Saininavjot/Capstone-Project-Group-1/BLOCK_DIAGRAM.png

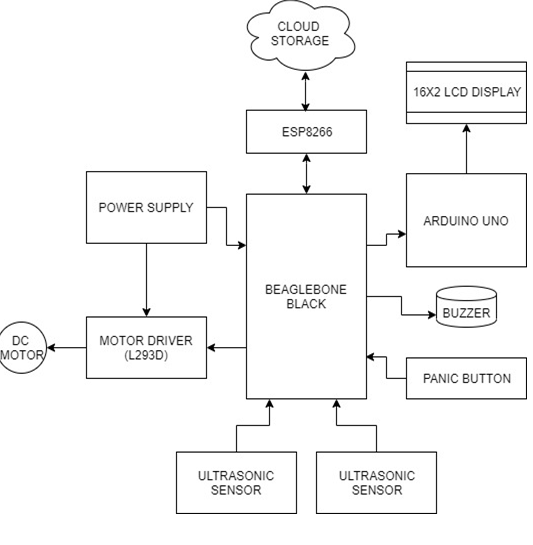
BLOCK_DIAGRAM.png
