Saininavjot/Capstone-Project-Group-1/(threads)

Thread 1 (2020-10-19):

Schematic Capture

mikeshams, 2020-10-19:
Navjot - What issues did you face working with fritzing? How did you resolve them?

Saininavjot, 2020-10-22:
There are various issues that I faced while working with fritzing software. I was learning this software and preparing schematic design for my project on this software:
 Issues that I faced while working with fritzing software are as follows:
1. Downloading and Installing Fritzing:
The latest version of fritzing is version 0.9.4, but this version is paid. However, I was looking for version that is free of cost. So, I downloaded fritzing version 0.9.3. But, it comes with its own cons. The version 0.9.3 does not have latest Microcontrollers like Beaglebone Black and latest interfacing modules.
To resolve this issue: There is option in fritzing to import parts from online library of fritzing. This worked for me to work with fritzing version 0.9.3.
2. To find all part libraries:
The first step to prepare schematic design on fritzing version 0.9.3 is to check whether fritzing have all required part libraries or not. In parts window, I searched for all parts required to prepare schematic design. I was able to find almost all modules like ultrasonic sensor, Arduino Uno, LCD Display etc. However, two modules that I would not able to find was Beaglebone Black and ESP 8266. As, fritzing version 0.9.3 do not have all modules preinstalled in it. Firstly, I tried to customize these two modules on Fritzing using any general IC, but it was time consuming as I have to describe each pin of that IC with Beaglebone black pins.
To resolve this issue: I tried to look for Fritzing parts library on internet specifically for Beaglebone black and ESP 8266. All the fritzing parts libraries have expension .fzpz. So, I looked specifically for beaglebone black with .fzpz extension file. I got this library on github: https://github.com/adafruit/Fritzing-Library/blob/master/parts/BeagleBone%20Black.fzpz
Similarly, I got .fzpz file for ESP 8266 from link given below:
https://github.com/ydonnelly/ESP8266_fritzing/blob/master/ESP8266-12E%20WiFi%20Module.fzpz
3. Setting up grid size for all parts:
Some of the parts appear quite big and are not aligned to grid. The grid size of new parts is different from old parts.
To resolve this issue: In part editor of each part, in view option. We can change grid size for each component to 0.1 inch and there is also option to align part to the grid. So, all the parts in the schematic diagram are aligned to –grid and set to grid size of 0.2 inch.

Closed 2020-10-23.

Thread 2 (2020-10-26):

Testing of components

mikeshams, 2020-10-26:
Ramneet - 1) What issues did you face with during testing the components? 2) How did you fix them?

embedded92, 2020-10-30:
Following are the problems I faced while testing the Hardware Components of the project:

1. Another issue I faced was a huge amount of inconsistency with the connections of the male jumper wires into the breadboard. For a long time, I thought I had bad components but later realized that it was the loose connections. Then few jumper wires were discarded and more attention was paid to these contacts.

2. To test LCD, I needed to use a potentiometer to adjust the contrast of the LCD screen. To adjust the potentiometer, it has a cross-head screw but I didn't have a cross-head screwdriver. The default setting of the potentiometer was set to min, which leads to no contrast on the LCD screen. First, I decided to use some resistance directly on the contrast pin, but it was taking more time to tune the contrast. Then while searching for some other components, I found an older potentiometer mixed with some resistors which have a slotted knob. Then I used that potentiometer to test the Lcd.

3. Another problem that we faced was during the testing of the buzzer. While testing the buzzer, I observed that it is not beeping correctly, First I tried to check the connections to the buzzer, but they were correct and properly connected to the buzzer which led me to realize that the buzzer was faulty. I changed the buzzer to the spare buzzer and then it was working as expected.

Closed 2020-10-30.

Thread 4 (2020-11-02):

Button & Buzzer Interfacing

mikeshams, 2020-11-02:
Navjot - 1) What issues did you face when interfacing the button and buzzer? 2) How did you resolve them? 3) On the terminal you were getting "Operation not permitted" error. How should you manage it?

embedded92, 2020-11-05:
Issues that we faced while Interfacing Buzzer and Push Button with Beaglebone Black:
1. Accessing GPIO pins of Beaglebone Black: The major issue is that we can not program the GPIO pins of Beaglebone Black directly. Multiple layers are present between user and Beaglebone Black. First of all, major challenge is to research about ways by which we can access the GPIO pins of Beaglebone Black.
Resolving this issue: We have done a thorough research and come across various ways of accessing and programming GPIO pins of Beaglebone black. Some of the methods are:
a) Using Command line terminal commands:
Before writing and reading data from the GPIO pins, we need to export the pins and give direction to the pin (input or output). We interact with BBB pins via a set of files that are read/written to. To reach the directory where these files are located, enter the following.
cd /sys/class/gpio
To access any GPIO pin, first need to export that file using command:
echo  22 > export, Where 22 represent gpio pin 22.
Echo 1 > value, to set value of pin 1 or 0
Echo out > direction, to send the direction of the pin
b)  Accessing pins through C library:
This method we have included in our project to access GPIO pins through C files:
Gpio.c and  Gpio.h, These files are included in our C project to access the pins.
The links for these files are:
https://gist.github.com/ajmontag/4013192
https://developer.ridgerun.com/wiki/index.php?title=Gpio-int-test.c
2. File path declaration in Program:
Earlier, in the program, we have not given full path of file to access pins. Because of this, program was showing error. Moreover, we get to know later on that we have to close file that means free up the pins before using these pins.
Resolving this Issue: The full path of file export path is given at which gpio pins are present on the gpio_control.c files. Everytime, if we want to read or write values to the pin, we have to give paths for files.
  fd = open("/sys/class/gpio/export", O_WRONLY);//file descriptor
We created a separated function called clean_up_system( ) in which we free up the pins to be used in main( ) function. So, before performing read and write operation in the main code, we called clean_up_system( ) function in main program.
/*
 * Freeup all the pins used in the project
 */
static void clean_up_system(void)
{
    // unexport and free up gpios
    gpio_control_free_pin(BUZZER_GPIO_PIN);
    gpio_control_free_pin(SWITCH_GPIO_PIN);
}
2. Terminal "Operation not permitted" error. How should you manage it?
While trying to access the GPIO pins through line, I faced issue while exporting pins. There is error “Operation not permitted” when I was running command : echo 22 > export.
To resolve this issue:
I research about this error on Google and come across various options to resolve this issue:
1. While accessing pins, I access the pins by becoming root user using command: sudo su
As a root, it is possible to access the pins.
Secondly, I unexport the pin first before exporting it. As, sometimes resources are busy, so to use any pin. First, we need to set the pin free by unexporting it.
echo 20 > unexport
root@beaglebone:/sys/class/gpio# ls
export  gpio111  gpio115  gpio13  gpio2   gpio26  gpio31  gpio35  gpio39  gpio46  gpio5   gpio61  gpio66  gpio7   gpio73  gpio77  gpio80  gpio88     gpiochip32
gpio10  gpio112  gpio116  gpio14  gpio20  gpio27  gpio32  gpio36  gpio4   gpio47  gpio50  gpio62  gpio67  gpio70  gpio74  gpio78  gpio81  gpio89     gpiochip64
gpio11  gpio113  gpio117  gpio15  gpio22  gpio3   gpio33  gpio37  gpio44  gpio48  gpio51  gpio63  gpio68  gpio71  gpio75  gpio79  gpio86  gpio9      gpiochip96
gpio110  gpio114  gpio12   gpio19  gpio23  gpio30  gpio34  gpio38  gpio45  gpio49  gpio60  gpio65  gpio69  gpio72  gpio76  gpio8   gpio87  gpiochip0  unexport
root@beaglebone:/sys/class/gpio# echo 20 > export
bash: echo: write error: Operation not permitted
root@beaglebone:/sys/class/gpio# echo 20 > unexport
bash: echo: write error: Invalid argument
root@beaglebone:/sys/class/gpio# echo 20 > unexport
bash: echo: write error: Invalid argument
root@beaglebone:/sys/class/gpio# echo 20 > export
root@beaglebone:/sys/class/gpio# cd gpio20
root@beaglebone:/sys/class/gpio/gpio20# echo out > direction
root@beaglebone:/sys/class/gpio/gpio20# cat direction
out
root@beaglebone:/sys/class/gpio/gpio20# echo 1 > value
root@beaglebone:/sys/class/gpio/gpio20# cat value
1
root@beaglebone:/sys/class/gpio/gpio20#

embedded92, 2020-11-05:
Issues that we faced while Interfacing Buzzer and Push Button with Beaglebone Black:
1. Accessing GPIO pins of Beaglebone Black: The major issue is that we can not program the GPIO pins of Beaglebone Black directly. Multiple layers are present between user and Beaglebone Black. First of all, major challenge is to research about ways by which we can access the GPIO pins of Beaglebone Black.
Resolving this issue: We have done a thorough research and come across various ways of accessing and programming GPIO pins of Beaglebone black. Some of the methods are:
a) Using Command line terminal commands:
Before writing and reading data from the GPIO pins, we need to export the pins and give direction to the pin (input or output). We interact with BBB pins via a set of files that are read/written to. To reach the directory where these files are located, enter the following.
cd /sys/class/gpio
To access any GPIO pin, first need to export that file using command:
echo  22 > export, Where 22 represent gpio pin 22.
Echo 1 > value, to set value of pin 1 or 0
Echo out > direction, to send the direction of the pin
b)  Accessing pins through C library:
This method we have included in our project to access GPIO pins through C files:
Gpio.c and  Gpio.h, These files are included in our C project to access the pins.
The links for these files are:
https://gist.github.com/ajmontag/4013192
https://developer.ridgerun.com/wiki/index.php?title=Gpio-int-test.c
2. File path declaration in Program:
Earlier, in the program, we have not given full path of file to access pins. Because of this, program was showing error. Moreover, we get to know later on that we have to close file that means free up the pins before using these pins.
Resolving this Issue: The full path of file export path is given at which gpio pins are present on the gpio_control.c files. Everytime, if we want to read or write values to the pin, we have to give paths for files.
  fd = open("/sys/class/gpio/export", O_WRONLY);//file descriptor
We created a separated function called clean_up_system( ) in which we free up the pins to be used in main( ) function. So, before performing read and write operation in the main code, we called clean_up_system( ) function in main program.
/*
 * Freeup all the pins used in the project
 */
static void clean_up_system(void)
{
    // unexport and free up gpios
    gpio_control_free_pin(BUZZER_GPIO_PIN);
    gpio_control_free_pin(SWITCH_GPIO_PIN);
}
2. Terminal "Operation not permitted" error. How should you manage it?
While trying to access the GPIO pins through line, I faced issue while exporting pins. There is error “Operation not permitted” when I was running command : echo 22 > export.
To resolve this issue:
I research about this error on Google and come across various options to resolve this issue:
1. While accessing pins, I access the pins by becoming root user using command: sudo su
As a root, it is possible to access the pins.
Secondly, I unexport the pin first before exporting it. As, sometimes resources are busy, so to use any pin. First, we need to set the pin free by unexporting it.
echo 20 > unexport
root@beaglebone:/sys/class/gpio# ls
export  gpio111  gpio115  gpio13  gpio2   gpio26  gpio31  gpio35  gpio39  gpio46  gpio5   gpio61  gpio66  gpio7   gpio73  gpio77  gpio80  gpio88     gpiochip32
gpio10  gpio112  gpio116  gpio14  gpio20  gpio27  gpio32  gpio36  gpio4   gpio47  gpio50  gpio62  gpio67  gpio70  gpio74  gpio78  gpio81  gpio89     gpiochip64
gpio11  gpio113  gpio117  gpio15  gpio22  gpio3   gpio33  gpio37  gpio44  gpio48  gpio51  gpio63  gpio68  gpio71  gpio75  gpio79  gpio86  gpio9      gpiochip96
gpio110  gpio114  gpio12   gpio19  gpio23  gpio30  gpio34  gpio38  gpio45  gpio49  gpio60  gpio65  gpio69  gpio72  gpio76  gpio8   gpio87  gpiochip0  unexport
root@beaglebone:/sys/class/gpio# echo 20 > export
bash: echo: write error: Operation not permitted
root@beaglebone:/sys/class/gpio# echo 20 > unexport
bash: echo: write error: Invalid argument
root@beaglebone:/sys/class/gpio# echo 20 > unexport
bash: echo: write error: Invalid argument
root@beaglebone:/sys/class/gpio# echo 20 > export
root@beaglebone:/sys/class/gpio# cd gpio20
root@beaglebone:/sys/class/gpio/gpio20# echo out > direction
root@beaglebone:/sys/class/gpio/gpio20# cat direction
out
root@beaglebone:/sys/class/gpio/gpio20# echo 1 > value
root@beaglebone:/sys/class/gpio/gpio20# cat value
1
root@beaglebone:/sys/class/gpio/gpio20#

Saininavjot, 2020-11-05:
Issues that we faced while Interfacing Buzzer and Push Button with Beaglebone Black:
1. Accessing GPIO pins of Beaglebone Black: The major issue is that we can not program the GPIO pins of Beaglebone Black directly. Multiple layers are present between user and Beaglebone Black. First of all, major challenge is to research about ways by which we can access the GPIO pins of Beaglebone Black.
Resolving this issue: We have done a thorough research and come across various ways of accessing and programming GPIO pins of Beaglebone black. Some of the methods are:
a) Using Command line terminal commands:
Before writing and reading data from the GPIO pins, we need to export the pins and give direction to the pin (input or output). We interact with BBB pins via a set of files that are read/written to. To reach the directory where these files are located, enter the following.
cd /sys/class/gpio
To access any GPIO pin, first need to export that file using command:
echo  22 > export, Where 22 represent gpio pin 22.
Echo 1 > value, to set value of pin 1 or 0
Echo out > direction, to send the direction of the pin
b)  Accessing pins through C library:
This method we have included in our project to access GPIO pins through C files:
Gpio.c and  Gpio.h, These files are included in our C project to access the pins.
The links for these files are:
https://gist.github.com/ajmontag/4013192
https://developer.ridgerun.com/wiki/index.php?title=Gpio-int-test.c
2. File path declaration in Program:
Earlier, in the program, we have not given full path of file to access pins. Because of this, program was showing error. Moreover, we get to know later on that we have to close file that means free up the pins before using these pins.
Resolving this Issue: The full path of file export path is given at which gpio pins are present on the gpio_control.c files. Everytime, if we want to read or write values to the pin, we have to give paths for files.
  fd = open("/sys/class/gpio/export", O_WRONLY);//file descriptor
We created a separated function called clean_up_system( ) in which we free up the pins to be used in main( ) function. So, before performing read and write operation in the main code, we called clean_up_system( ) function in main program.
/*
 * Freeup all the pins used in the project
 */
static void clean_up_system(void)
{
    // unexport and free up gpios
    gpio_control_free_pin(BUZZER_GPIO_PIN);
    gpio_control_free_pin(SWITCH_GPIO_PIN);
}
2. Terminal "Operation not permitted" error. How should you manage it?
While trying to access the GPIO pins through line, I faced issue while exporting pins. There is error “Operation not permitted” when I was running command : echo 22 > export.
To resolve this issue:
I research about this error on Google and come across various options to resolve this issue:
1. While accessing pins, I access the pins by becoming root user using command: sudo su
As a root, it is possible to access the pins.
Secondly, I unexport the pin first before exporting it. As, sometimes resources are busy, so to use any pin. First, we need to set the pin free by unexporting it.
echo 20 > unexport
root@beaglebone:/sys/class/gpio# ls
export  gpio111  gpio115  gpio13  gpio2   gpio26  gpio31  gpio35  gpio39  gpio46  gpio5   gpio61  gpio66  gpio7   gpio73  gpio77  gpio80  gpio88     gpiochip32
gpio10  gpio112  gpio116  gpio14  gpio20  gpio27  gpio32  gpio36  gpio4   gpio47  gpio50  gpio62  gpio67  gpio70  gpio74  gpio78  gpio81  gpio89     gpiochip64
gpio11  gpio113  gpio117  gpio15  gpio22  gpio3   gpio33  gpio37  gpio44  gpio48  gpio51  gpio63  gpio68  gpio71  gpio75  gpio79  gpio86  gpio9      gpiochip96
gpio110  gpio114  gpio12   gpio19  gpio23  gpio30  gpio34  gpio38  gpio45  gpio49  gpio60  gpio65  gpio69  gpio72  gpio76  gpio8   gpio87  gpiochip0  unexport
root@beaglebone:/sys/class/gpio# echo 20 > export
bash: echo: write error: Operation not permitted
root@beaglebone:/sys/class/gpio# echo 20 > unexport
bash: echo: write error: Invalid argument
root@beaglebone:/sys/class/gpio# echo 20 > unexport
bash: echo: write error: Invalid argument
root@beaglebone:/sys/class/gpio# echo 20 > export
root@beaglebone:/sys/class/gpio# cd gpio20
root@beaglebone:/sys/class/gpio/gpio20# echo out > direction
root@beaglebone:/sys/class/gpio/gpio20# cat direction
out
root@beaglebone:/sys/class/gpio/gpio20# echo 1 > value
root@beaglebone:/sys/class/gpio/gpio20# cat value
1
root@beaglebone:/sys/class/gpio/gpio20#

Closed 2020-11-13.

Thread 8 (2020-11-10):

Interfacing the ultra sonic

mikeshams, 2020-11-10:
Ramneet - 1) What issues did you face when interfacing the ultra sonic? 2) How did you resolve them?

embedded92, 2020-11-13:
Issues that I faced while interfacing Ultrasonic sensors with Beaglebone black are as follows:

1. Issue: Ultrasonic sensor requires a 5v operating power supply. Firstly, I tried to power ultrasonic sensors from beaglebone onboard VDD power supply of 5v. But, when 0I tried running code on the terminal, there was no output from the ultrasonic sensor. I checked all the connections and code again, but still, the sensors were not operating.

Resolving this issue: I tried to find the underlying cause of this issue. One of the points that I get to know is that the Beaglebone black on board VDD pin only works if beaglebone is connected to power adaptor and getting constant 5 VDC, 2.5 A, barrel-plug supply. Another point I get to know is SYS 5v can be used if current drawn from the board by a sensor is under 500 m A. The SYS 5V pin can be used if Beaglebone black is powered by a USB cable. As, the ultrasonic sensor only draws 15 mA of current, so it is safe to use the SYS 5V pin to power beaglebone black.

https://cdn-shop.adafruit.com/datasheets/BBB_SRM.pdf

2. Issue: Earlier, in the code, I did not mention about range in centimeter within which ultrasonic sensor should detect obstacles. As in our project, the ultrasonic sensors' role is to detect the arrival and departure of the train, and sensors were placed just 3m to 4 cm away from the railway track. Earlier, this range was not specified. So, sensors were detecting any objects even from a far distance like walls, tables, etc.

Resolving this Issue: In the code, I mentioned about specific range within which sensors should detect train. If the distance is between 4 and 6 cm, then only the sensor will detect that object like a train.

if ( distance>= 4 && distance =< 6)
            {
                        printf("train arriving......\r\n");
                        printf("Distance= %d \r\n", distance);
                        printf("\r\n", distance);
            }

3. Issue: Earlier, I did not get the perfect library to access the GPIO pins of Beaglebone Black. There are few general libraries that can be used for any processor for accessing GPIO pins. But, I was not able to find specifically for beaglebone black.

Resolving this Issie:
I come across the specific library for beaglebone black, i.e., IOBB library at GitHub:

https://github.com/shabaz123/iobb

There were few steps to be followed while installing and downloading IOBB library.
1.         mkdir development
2.         cd development
3.         git clone https://github.com/shabaz123/iobb.git
4.         cd iobb
5.         make
6.         make install

Closed 2020-11-13.

Thread 9 (2020-11-16):

Interfacing stepper motor with BeagleBone Black

mikeshams, 2020-11-16:
Navjot - What issues did you face when Interfacing stepper motor with BeagleBone Black? How did you resolve them?

Saininavjot, 2020-11-20:
Issues that I faced while interfacing stepper motor with BBB are as follows:
1. Writing C code for stepper motor:
Programming stepper motor was bit challenging for us as we have to rotate motor in clockwise of anticlockwise direction using GPIO pins of Beaglebone Black. Programming stepper motor is not as easy as DC motor. Here, we have to configure step size and number of steps to be taken by motor to rotate at particular angle. First challenge was to research about how to calculate number of steps for 90 degree rotation of stepper motor. We write the C code for stepper motor, but while running the code on linux terminal, motor was not responding. There was some issue in the code.
Resolving this issue: All the connections were fine but code was working as per requirement to rotate the motor. Then, we researched about functioning of stepper motor and we get to know some basic details about motor such as how to calculate number of steps from step angle. Secondly, it is important to decide whether to use 4 step sequence or 8 step sequence to rotation of motor.
We decided to go with 4 step sequence,  that means combination of wires are as follows:
AB-BC-CD-DA
We followed to following links to program our stepper motor.
1. This link provide us with basic understanding to program stepper motor in 4 step sequence
https://www.instructables.com/BYJ48-Stepper-Motor/
2. This link helps us to write C code for stepper motor interfacing with Beaglebone Black.
https://bwgz57.wordpress.com/2012/04/03/beaglebone-stepping-out/
To calculate number of steps for 90 degree rotation in 4 step sequences, the formula used is as follows:
 Steps = Number of steps in One Revolution * Gear ratio = 32*64 = 2048
To rotate by 90 degree: 2048/4 = 512
2. Appropriate power supply:
The second issue is to power ULN2003 driver from appropriate power source. ULN2003 driver further power stepper motor with required voltage and current. Earlier, we powered ULN2003 driver from Beaglebone Black 5v on board pin. But, powering high current motor from Beaglebone Black can result in destruction of Microcontroller. So, we need some alternative so as to make sure that Beaglebone is operated in safe condition without its failure.
To resolve this issue: We decided to use external power module for power our ULN2003 driver. So, we used adjustable power module that can provide power from range 3.3V to 12 V to any device that is operated in this range. This power module is further connected to power adaptor. The power module provide 5V power supply to driver circuit as well as appropriate current of 500 mA.

Closed 2020-11-20.

Thread 12 (2020-11-24):

interfacing the WiFi Module

mikeshams, 2020-11-24:
Ramneet - 1) What issues did you encounter when interfacing the WiFi Module? 2) How did you resolve them?

embedded92, 2020-11-27:
While interfacing beaglebone with esp8266 I faced the problem that the Arduino platform for ESP only supports two UART and 2nd UART of ESP only supports TX. For our testing, I needed two UARTs as one is connected to beaglebone and 2nd is used for seeing the logs.
I tried using UART 2 for seeing the logs, but it was not working properly. To resolve this I switched to using software UART which enables using any GPIO pins of ESP to be used as UART. I finally used D5 and D6 GPIO pin of ESP as RX and TX respectively and for this "SoftwareSerial.h" header file was used.

Closed 2020-11-27.

Thread 15 (2020-12-01):

interfacing the project to the cloud

mikeshams, 2020-12-01:
Ramneet - What issues did you face interfacing the project to the cloud? How did you resolve them? Modify the charts as instructed.

embedded92, 2020-12-04:
-Issues faced while interfacing the project to the cloud:
Sometimes due to the low signal strength of wifi(usually between -70to -80dBm) in my room, ESP8266 was not able to connect to Wi-Fi and hence was not able to connect to MQTT broker(cloud).
To resolve this issue I had to move out of my room and then try the connection, also I requested my pg owner to install a signal repeater.

-Modify the charts as instructed:
We are using the trial version of thingspeak that has only limited options to add visuals and graphs to represent data. We have tried to make a few changes to make data representation more clear and readable. In order to do so, we have done two 2 things, first, added titles to the X and Y axis, and second, added a button-like visual to Field 4 which represents the "Emergency" situation.

-Bug:
While demonstrating the project in the class after my presentation, I was not able to show updated data on the cloud. The reason being, while making the hardware connections more clear I somehow connected the RX and TX of BBB-ESP8266 wrong(used 9-11 instead of 11-13 pins of BBB). Due to which BBB was not able to send any data to ESP and ESP was unable to update the cloud.
I, later on, made the connections right and gave a demo in the class.

Closed 2020-12-04.

Thread 16 (2020-12-08):

Interfacing the LCD Display to the BBB

mikeshams, 2020-12-08:
Navjot - 1) What issues did you face when Interfacing the LCD Display to the BBB? 2) How did you resolve them? 3) Why did not you use I2C protocol for communication? 4) Why are not you able to change the font size?

Saininavjot, 2020-12-11:
Issues that I faced while interfacing LCD Display with BBB:
1. Interfacing Arduino Uno with BBB:
The GPIO pins of Beaglebone black are 3.3V and can be configured as inputs or outputs. The max output current varies by pin. For some pins it is 4mA and for some pins it is 6mA. The inputs are not 5V tolerant. The max voltage is 3.3V for GPIO pins. On the other hand, Input and output pins of Arduino Uno require operating voltage of 5V. If 5v signal is send back from Arduino Uno to BBB, it can destroy the Beaglebone board.
Resolving issue: Earlier, we thought of using Logic level convertor between Arduino and BBB. As logic level convertor converts 5v signal to 3.3v which is further given as input to the BBB. But, in our project, we do not require any acknowledgement of letters (data) received by Arduino back to BBB. We are not sending any data back to Beaglebone black. There is only transmission of data from BBB to receiver pin of Arduino. So, board is operated in safe conditions and our purpose is served as well.
2. Running code on Arduino IDE: When I tried to upload code into Arduino Board using Arduino IDE. It was showing error in code uploading and failed to upload the code. An error was displayed on the IDE.
Resolving Issue: As Arduino Board was connected with Laptop using USB cable. The Arduino IDE was sending code to Arduino Board using USB protocol. Also, the receiver pin of the Arduino board was connected to transmission pin of BBB. As Arduino Board was receiving data from BBB using UART protocol. So, there was conflict between these data from Arduino IDE and BBB. So, we remove the receiver pin connection of Arduino Board with BBB while uploading code to the Arduino Board. When we tried to re-upload code into Arduino Uno, then problem was solved and uploading was done successfully.
3. Why did not you use I2C protocol for communication?
To interface the LCD with Beaglebone black using I2C protocol, we require extra PCF8574 expander module that support I2C communication with Beaglebone black. Some LCD have PCF module already attached to it. The LCD which we are using does not have this attached module to support I2C communication. So, we did not use I2C protocol for communication. Other option we were having is parallel communication between LCD and BBB in 4 bit mode or 8 bit mode. But, this require many GPIO pins of BBB to interface LCD in 4 bit mode or 8 bit mode.
To resolve this issue: We made use of Arduino Uno as intermediate device between BBB and LCD Display. The Arduino Uno is interfaced with BBB using UART protocol and only one UART transmission pin is used of BBB as the data is only transmitted from BBB to Arduino Uno. The Arduino uno board is further interfaced with LCD Display using parallel communication in 4 bit mode.
4. Why are not you able to change the font size?
The LCD which we are using only supports font size of 5×8 dot matrix. We have looked for its specification from digikey site from where we ordered it and it was clearly mentioned on the website that it font size is 5×8 dot matrix.
https://www.digikey.ca/en/products/detail/matrix-orbital/MOP-AL162A-BYFY-25J-3IN/9602838

Closed 2020-12-11.

Thread 18 (2020-12-14):

PCB and more

mikeshams, 2020-12-14:
Navjot and Ramneet - What's the difference between a breadboard PCB and a Zero PCB? Why do you think your project has Real time processing features without FreeRTOS?

Saininavjot, 2020-12-18:
What the difference between a breadboard PCB and a Zero PCB?
Zero PCB: Zero PCB is basically a general-purpose printed circuit board (PCB), also known as perfboard or DOT PCB. It is a thin rigid copper sheet with holes pre-drilled at standard intervals across a grid with 2.54mm (0.1-inch) spacing between holes. Each hole is encircled by a round or square copper pad so that component lead can be inserted into the hole and soldered around the pad without short-circuiting the nearby pads and other leads. For connecting the lead of component with another lead, solder these together or join these using a suitable conducting wire.
Solderable Breadboard PCB: The soldereable breadboard would be a good alternative to custom PCB for the projects, since the layout of the holes are nearly identical to that of the solder less breadboard. In some cases, it is better to prototype the circuit straight to the solderable breadboard. After testing the circuit on the Breadboard, then the prototype can be copied exactly to the soderable Breadboard. However, on the Zero PCB, one needs to re-arrange the circuit and have to create a PCB design before soldering the components on the Zero PCB. Moreover, in zerp PCB, traces have to be made with solder wire. But in Breadboard PCB, there is no need to create PCB design. Only thing that is needs to be done in breadboard PCB is to copy the circuit from Breadboard to solderable Breadboard and solder it permanently. The hole pattern of solderable Breadboard matches solderless breadboards of the same size.

embedded92, 2020-12-18:
There are two types of RTOS depending on the applications
1) hard real-time OS
2) Soft real-time OS

Freertos can be used as both, depending on the application and implementation. in our project, we have used Embedded Linux on Beaglebone black which is a soft real-time operating system.
One of the main features of RTOS is the ability to run multiple tasks in a timely manner. In our project, we have used multiple threads using "pthread" library for different components of the system. And scheduler of our embedded Linux kernel schedules them in a timely manner. In multi-threaded implementation different components seem to work in parallel and tasks will not wait for one another to be completed. It is the scheduler that uses different scheduling techniques to make the system work in Real-Time.
So, we can conclude that our system is working in Real-Time but this project is a soft Real-Time application.

Closed 2020-12-18.
