Saininavjot/Capstone-Project-Group-1/Codes/threads_integration-13-12-2020/push_button.h

#ifndef PUSH_BUTTON_H
#define PUSH_BUTTON_H

#include "common.h"

/*
 * initialize push button thread
 * 
 * @return      : SUCCESS or ERROR
 */
results push_button_thread_init(void);


#endif //PUSH_BUTTON_H
