Saininavjot/Capstone-Project-Group-1/(commit log)

2020-10-06 Block Diagram
    Block Diagram of IoT based Automatic Railway Gate Controller
2020-10-19 Project Schematic Diagram
    Schematic Diagram is designed on Fritzing software version 0.9.3
2020-10-19 Presentation on Schematic Designing
2020-11-02 Adding push button and buzzer interfacing code
    [gpio_control.c, gpio_control.h, main.c]
2020-11-02 GPIO Pin interfacing with BBB
2020-11-09 adding interfacing of bbb with ultrasonic sensor
2020-11-16 Stepper motor interfacing with beaglebone black
2020-11-16 Interfacing stepper motor with Beaglebone black
2020-11-30 Updated integrated threads
2020-12-08 PCB Design PPT
2020-12-08 PCB Design
